erdoganeray/desk_buddy/kicad/Desk Buddy.kicad_pcb

## KiCad design eval/baro.kicad_sch

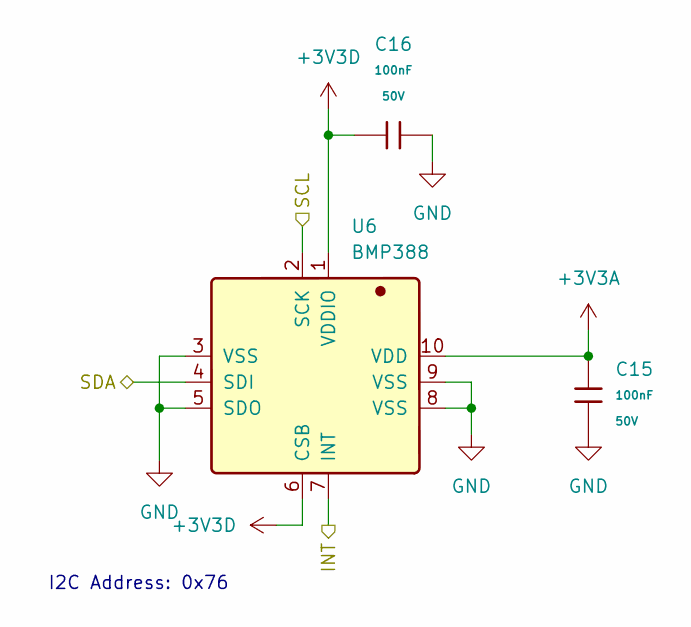
[picture p1: schematic baro.kicad_sch]

Parts:
C15, C16: 100nF; C_0805; Voltage Rated 50V; Tolerance ±10%; Part CC0805KRX7R9BB104; LCSC C49678
U6: BMP388; Manufacturer Part BMP388; LCSC C779278

Connections:
+3V3A: C15.1, U6.10 (VDD)
+3V3D: C16.1, U6.1 (VDDIO), U6.6 (CSB)
GND: C15.2, C16.2, U6.3 (VSS), U6.5 (SDO), U6.8 (VSS), U6.9 (VSS)
INT: U6.7 (INT)
SCL: U6.2 (SCK)
SDA: U6.4 (SDI)

Notes on the sheet:
I2C Address: 0x76
