erdoganeray/desk_buddy/kicad/Desk Buddy.kicad_pcb

## KiCad design eval/imu0.kicad_sch

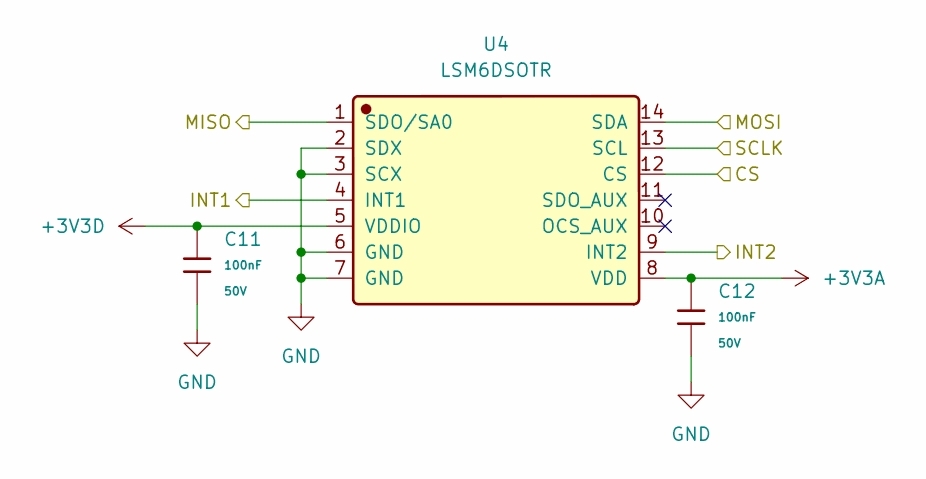
[picture p2: schematic imu0.kicad_sch]

Parts:
C11, C12: 100nF; C_0805; Voltage Rated 50V; Tolerance ±10%; Part CC0805KRX7R9BB104; LCSC C49678
U4: LSM6DSOTR; Bosch_LGA-14_3x2.5mm_P0.5mm; Manufacturer Part LSM6DSOTR; LCSC C2655100

Connections:
+3V3A: C12.1, U4.8 (VDD)
+3V3D: C11.1, U4.5 (VDDIO)
CS: U4.12 (CS)
GND: C11.2, C12.2, U4.2 (SDX), U4.3 (SCX), U4.6 (GND), U4.7 (GND)
INT1: U4.4 (INT1)
INT2: U4.9 (INT2)
MISO: U4.1 (SDO/SA0)
MOSI: U4.14 (SDA)
SCLK: U4.13 (SCL)
