erdoganeray/desk_buddy/kicad/Desk Buddy.kicad_pcb

## KiCad design eval/imu1.kicad_sch

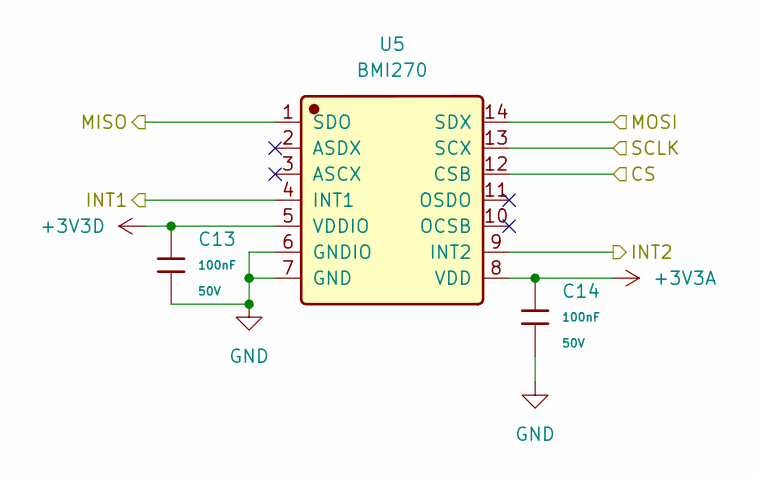
[picture p3: schematic imu1.kicad_sch]

Parts:
C13, C14: 100nF; C_0805; Voltage Rated 50V; Tolerance ±10%; Part CC0805KRX7R9BB104; LCSC C49678
U5: BMI270; Bosch_LGA-14_3x2.5mm_P0.5mm; Manufacturer Part BMI270; LCSC C2836813

Connections:
+3V3A: C14.1, U5.8 (VDD)
+3V3D: C13.1, U5.5 (VDDIO)
CS: U5.12 (CSB)
GND: C13.2, C14.2, U5.6 (GNDIO), U5.7 (GND)
INT1: U5.4 (INT1)
INT2: U5.9 (INT2)
MISO: U5.1 (SDO)
MOSI: U5.14 (SDX)
SCLK: U5.13 (SCX)
