erdoganeray/desk_buddy/kicad/Desk Buddy.kicad_pcb

## KiCad design eval/mag.kicad_sch

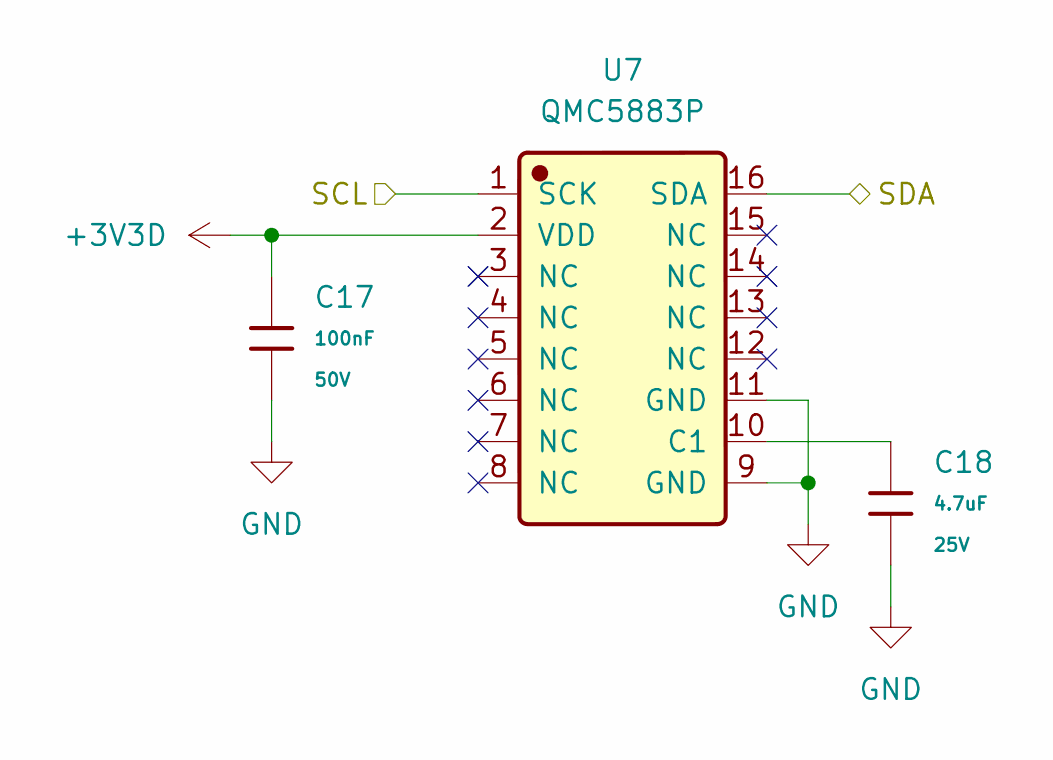
[picture p4: schematic mag.kicad_sch]

Parts:
C17: 100nF; C_0805; Voltage Rated 50V; Tolerance ±10%; Part CC0805KRX7R9BB104; LCSC C49678
C18: 4.7uF; C_0805; Voltage Rated 25V; Tolerance ±10%; Part CL21A475KAQNNNE; LCSC C1779
U7: QMC5883P; LGA-16_3x3mm_P0.5mm; Manufacturer Part QMC5883P; LCSC C2847467

Connections:
+3V3D: C17.1, U7.2 (VDD)
GND: C17.2, C18.2, U7.9 (GND), U7.11 (GND)
unnamed: C18.1, U7.10 (C1)
SCL: U7.1 (SCK)
SDA: U7.16 (SDA)
