erdoganeray/desk_buddy/kicad/Desk Buddy.kicad_pcb

## KiCad design eval/mcu.kicad_sch

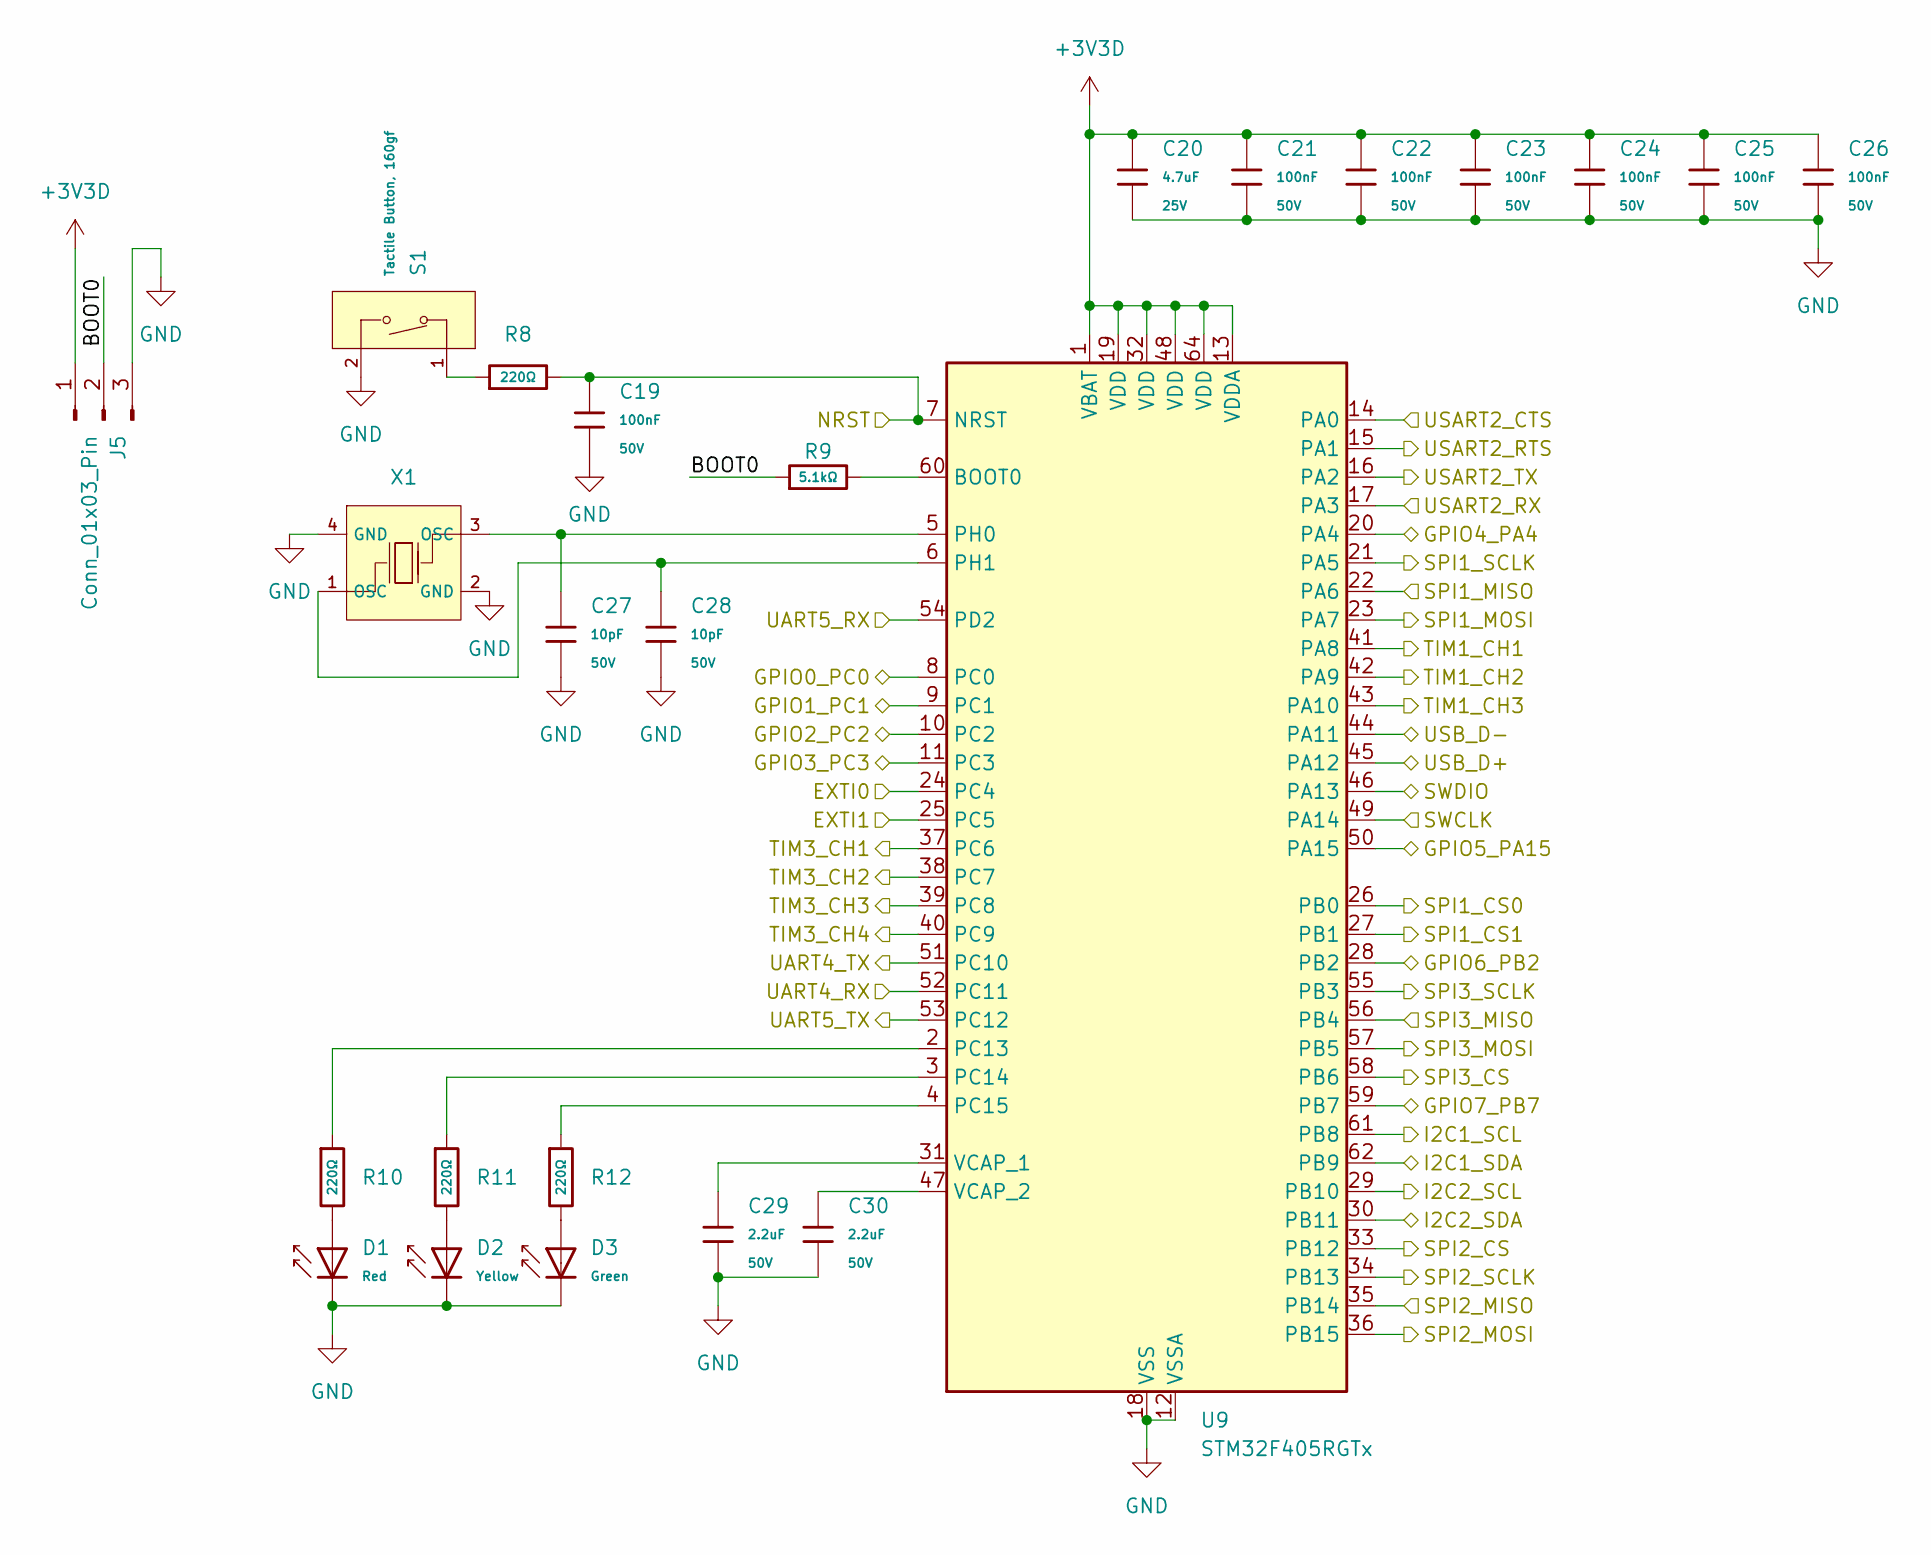
[picture p5: schematic mcu.kicad_sch]

Parts:
C19, C21, C22, C23, C24, C25, C26: 100nF; C_0805; Voltage Rated 50V; Tolerance ±10%; Part CC0805KRX7R9BB104; LCSC C49678
C20: 4.7uF; C_0805; Voltage Rated 25V; Tolerance ±10%; Part CL21A475KAQNNNE; LCSC C1779
C27, C28: 10pF; C_0603; Voltage Rated 50V; Tolerance ±5%; Part CL10C100JB8NNNC; LCSC C1634
C29, C30: 2.2uF; C_0805; Voltage Rated 50V; Tolerance ±10%; Part CL21A225KBQNNNE; LCSC C377773
D1: Red; D_0805; Forward Voltage (VF) 1.6V~2.6V; Part NCD0805R1; LCSC C84256
D2: Yellow; D_0805; Part KT-0805Y; LCSC C2296
D3: Green; D_0805; Part KT-0805G; LCSC C2297
J5: Conn_01x03_Pin; PinHeader_1x03_P2.54mm_Vertical
R8, R10, R11, R12: 220Ω; R_0805; Overload Voltage (Max) 150V; Tolerance ±1%; Part 0805W8F2200T5E; LCSC C17557
R9: 5.1kΩ; R_0805; Overload Voltage (Max) 150V; Tolerance ±1%; Part 0805W8F5101T5E; LCSC C27834
S1: Tactile Button, 160gf; SW_TS-1088-AR02016; Voltage Rating (Dc) 12V; Part TS-1088-AR02016; LCSC C720477
U9: STM32F405RGTx; LQFP-64_10x10mm_P0.5mm
X1: X322516MLB4SI; OSC-SMD_4P-L3.2-W2.5-BL; Frequency Tolerance ±10ppm; Part X322516MLB4SI; LCSC C13738

Connections:
+3V3D: C20.1, C21.1, C22.1, C23.1, C24.1, C25.1, C26.1, J5.1, U9.1 (VBAT), U9.13 (VDDA), U9.19 (VDD), U9.32 (VDD), U9.48 (VDD), U9.64 (VDD)
BOOT0: J5.2, R9.1
EXTI0: U9.24 (PC4)
EXTI1: U9.25 (PC5)
GND: C19.2, C20.2, C21.2, C22.2, C23.2, C24.2, C25.2, C26.2, C27.2, C28.2, C29.2, C30.2, D1.1, D2.1, D3.1, J5.3, S1.2 (B), U9.12 (VSSA), U9.18 (VSS), U9.63 (VSS), X1.2 (GND), X1.4 (GND)
GPIO0_PC0: U9.8 (PC0)
GPIO1_PC1: U9.9 (PC1)
GPIO2_PC2: U9.10 (PC2)
GPIO3_PC3: U9.11 (PC3)
GPIO4_PA4: U9.20 (PA4)
GPIO5_PA15: U9.50 (PA15)
GPIO6_PB2: U9.28 (PB2)
GPIO7_PB7: U9.59 (PB7)
I2C1_SCL: U9.61 (PB8)
I2C1_SDA: U9.62 (PB9)
I2C2_SCL: U9.29 (PB10)
I2C2_SDA: U9.30 (PB11)
NRST: C19.1, R8.2, U9.7 (NRST)
unnamed: C27.1, U9.5 (PH0), X1.3 (OSC)
unnamed: C28.1, U9.6 (PH1), X1.1 (OSC)
unnamed: C29.1, U9.31 (VCAP_1)
unnamed: C30.1, U9.47 (VCAP_2)
unnamed: D1.2, R10.2
unnamed: D2.2, R11.2
unnamed: D3.2, R12.2
unnamed: R8.1, S1.1 (A)
unnamed: R9.2, U9.60 (BOOT0)
unnamed: R10.1, U9.2 (PC13)
unnamed: R11.1, U9.3 (PC14)
unnamed: R12.1, U9.4 (PC15)
SPI1_CS0: U9.26 (PB0)
SPI1_CS1: U9.27 (PB1)
SPI1_MISO: U9.22 (PA6)
SPI1_MOSI: U9.23 (PA7)
SPI1_SCLK: U9.21 (PA5)
SPI2_CS: U9.33 (PB12)
SPI2_MISO: U9.35 (PB14)
SPI2_MOSI: U9.36 (PB15)
SPI2_SCLK: U9.34 (PB13)
SPI3_CS: U9.58 (PB6)
SPI3_MISO: U9.56 (PB4)
SPI3_MOSI: U9.57 (PB5)
SPI3_SCLK: U9.55 (PB3)
SWCLK: U9.49 (PA14)
SWDIO: U9.46 (PA13)
TIM1_CH1: U9.41 (PA8)
TIM1_CH2: U9.42 (PA9)
TIM1_CH3: U9.43 (PA10)
TIM3_CH1: U9.37 (PC6)
TIM3_CH2: U9.38 (PC7)
TIM3_CH3: U9.39 (PC8)
TIM3_CH4: U9.40 (PC9)
UART4_RX: U9.52 (PC11)
UART4_TX: U9.51 (PC10)
UART5_RX: U9.54 (PD2)
UART5_TX: U9.53 (PC12)
USART2_CTS: U9.14 (PA0)
USART2_RTS: U9.15 (PA1)
USART2_RX: U9.17 (PA3)
USART2_TX: U9.16 (PA2)
USB_D+: U9.45 (PA12)
USB_D-: U9.44 (PA11)
