erdoganeray/desk_buddy/kicad/Desk Buddy.kicad_pcb

## KiCad design eval/power.kicad_sch

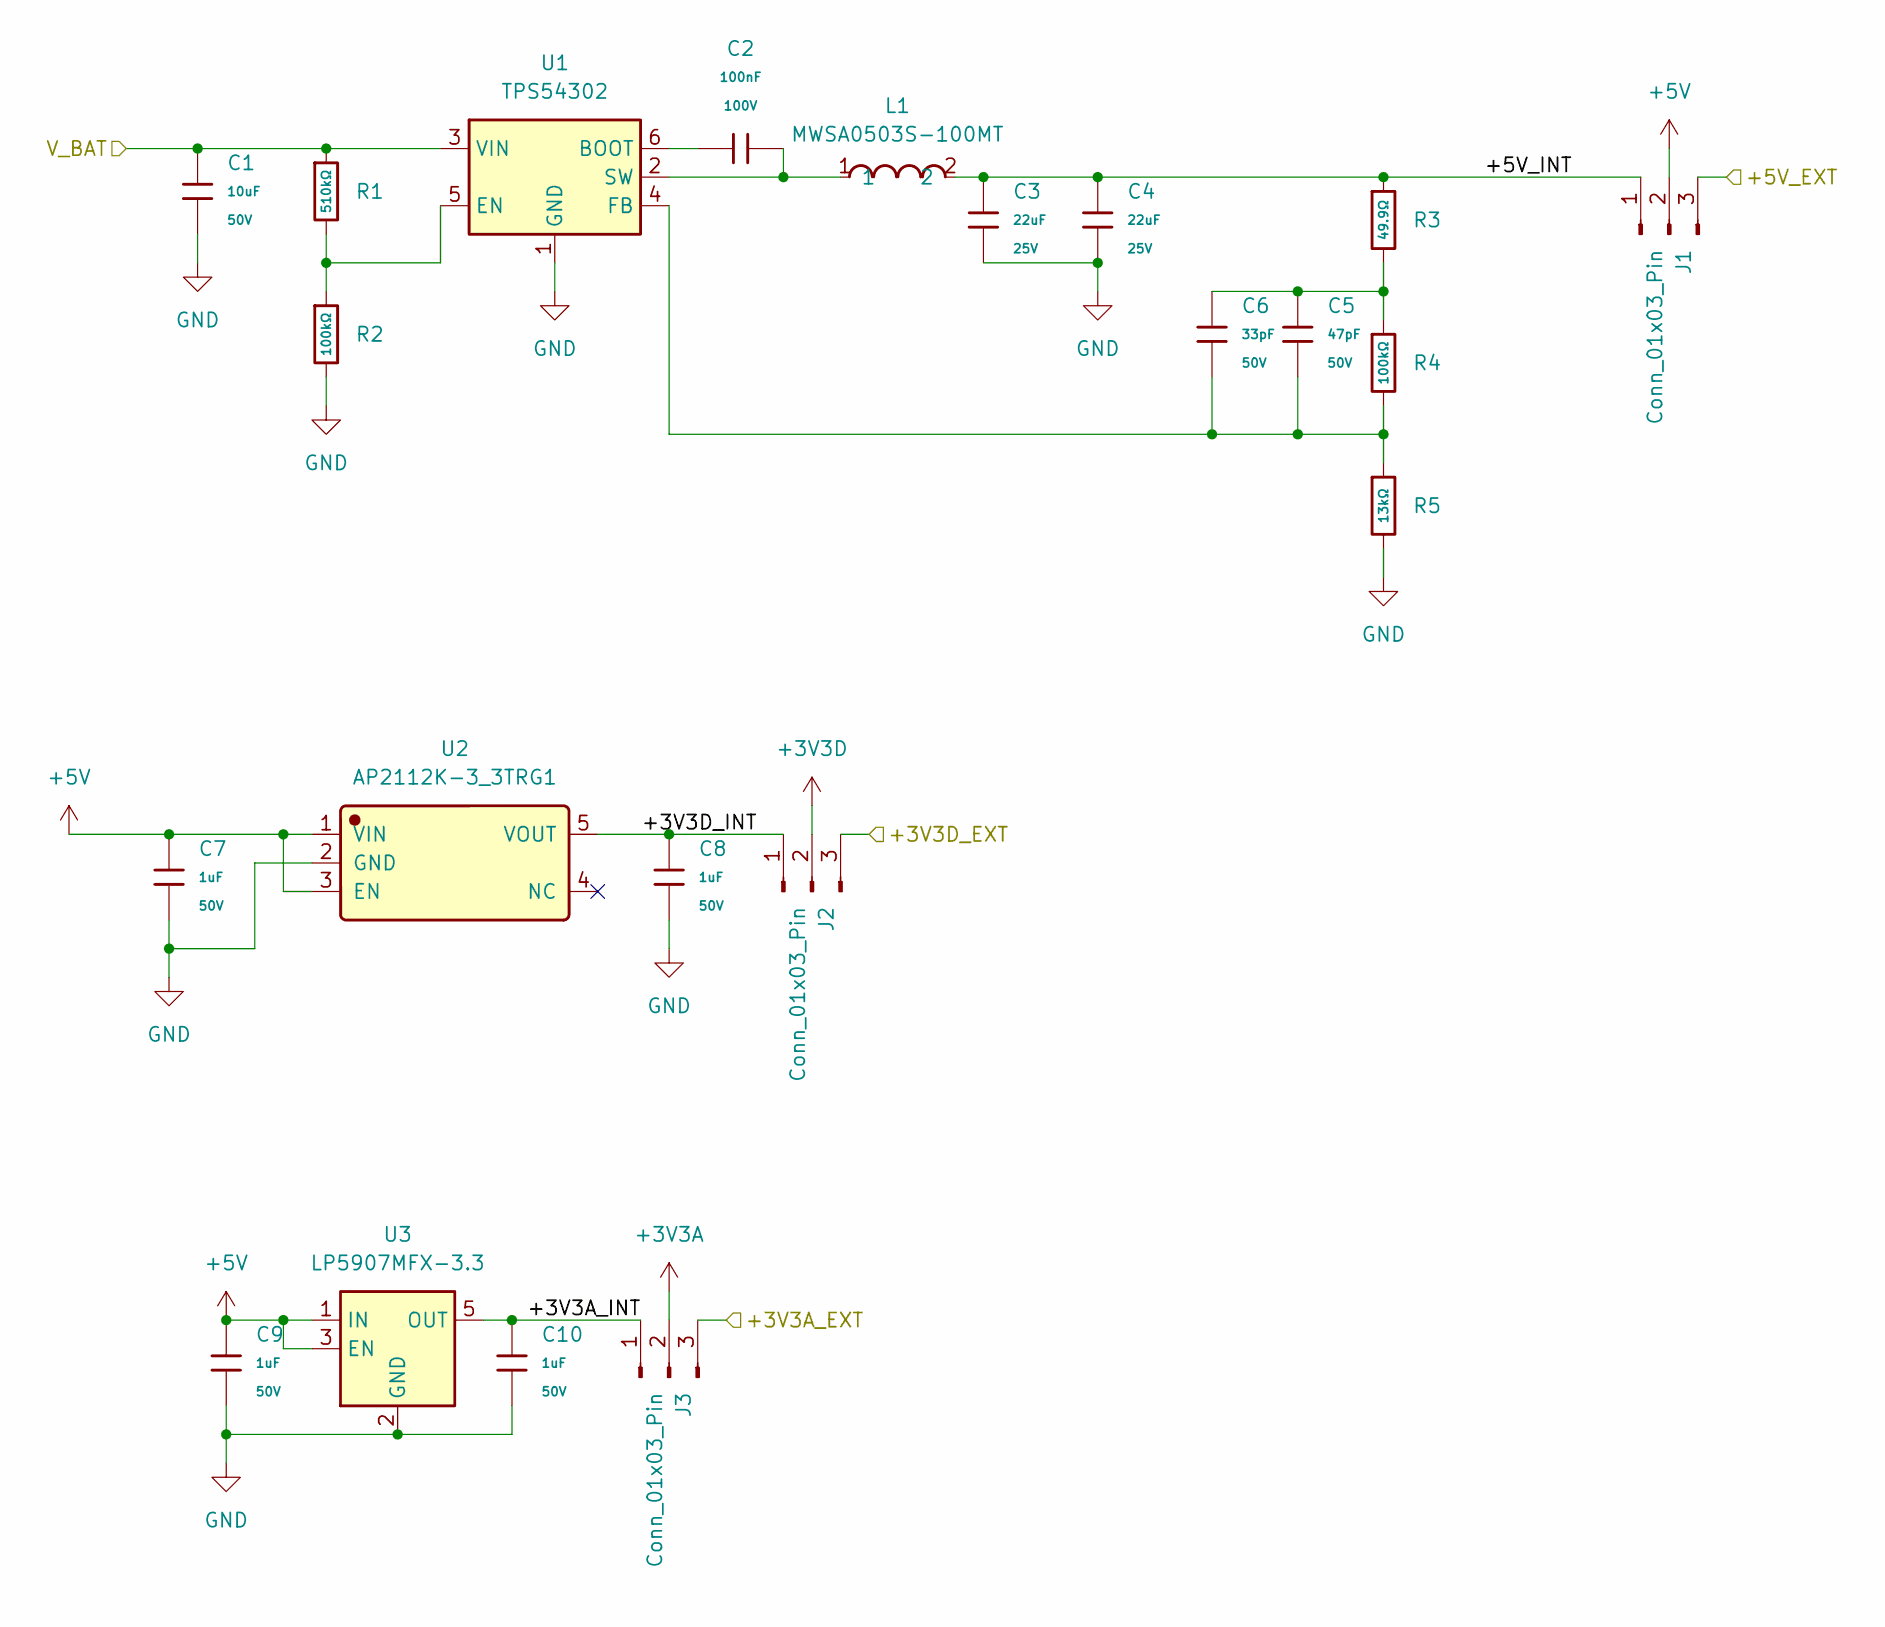
[picture p6: schematic power.kicad_sch]

Parts:
C1: 10uF; C_0805; Voltage Rated 50V; Tolerance ±10%; Part GRM21BR61H106KE43L; LCSC C440198
C2: 100nF; C_0805; Voltage Rated 100V; Tolerance ±10%; Part CL21B104KCFNNNE; LCSC C28233
C3, C4: 22uF; C_0805; Voltage Rated 25V; Tolerance ±20%; Part CL21A226MAQNNNE; LCSC C45783
C5: 47pF; C_0805; Voltage Rated 50V; Tolerance ±5%; Part CL21C470JBANNNC; LCSC C14857
C6: 33pF; C_0805; Voltage Rated 50V; Tolerance ±5%; Part CC0805JRNPO9BN330; LCSC C107115
C7, C8, C9, C10: 1uF; C_0805; Voltage Rated 50V; Tolerance ±10%; Part CL21B105KBFNNNE; LCSC C28323
J1, J2, J3: Conn_01x03_Pin; PinHeader_1x03_P2.54mm_Vertical
L1: MWSA0503S-100MT; SOIC-8_L5.3-W5.3-P1.27-LS8.0-BL; Manufacturer Part MWSA0503S-100MT; LCSC C408412
R1: 510kΩ; R_0805; Overload Voltage (Max) 150V; Tolerance ±1%; Part 0805W8F5103T5E; LCSC C17733
R2, R4: 100kΩ; R_0805; Overload Voltage (Max) 150V; Tolerance ±1%; Part 0805W8F1003T5E; LCSC C149504
R3: 49.9Ω; R_0805; Overload Voltage (Max) 150V; Tolerance ±1%; Part 0805W8F499JT5E; LCSC C17720
R5: 13kΩ; R_0805; Overload Voltage (Max) 150V; Tolerance ±1%; Part 0805W8F1302T5E; LCSC C17455
U1: TPS54302; SOT-23-6
U2: AP2112K-3_3TRG1; SC-74-6_1.55x2.9mm_P0.95mm; Manufacturer Part AP2112K-3.3TRG1; LCSC C51118
U3: LP5907MFX-3.3; SOT-23-5

Connections:
+3V3A: J3.2
+3V3A_EXT: J3.3
+3V3A_INT: C10.1, J3.1, U3.5 (OUT)
+3V3D: J2.2
+3V3D_EXT: J2.3
+3V3D_INT: C8.1, J2.1, U2.5 (VOUT)
+5V: C7.1, C9.1, J1.2, U2.1 (VIN), U2.3 (EN), U3.1 (IN), U3.3 (EN)
+5V_EXT: J1.3
+5V_INT: C3.1, C4.1, J1.1, L1.2, R3.1
GND: C1.2, C3.2, C4.2, C7.2, C8.2, C9.2, C10.2, R2.2, R5.2, U1.1 (GND), U2.2 (GND), U3.2 (GND)
unnamed: C2.1, U1.6 (BOOT)
unnamed: C2.2, L1.1, U1.2 (SW)
unnamed: C5.1, C6.1, R3.2, R4.1
unnamed: C5.2, C6.2, R4.2, R5.1, U1.4 (FB)
unnamed: R1.2, R2.1, U1.5 (EN)
V_BAT: C1.1, R1.1, U1.3 (VIN)
