erdoganeray/desk_buddy/kicad/Desk Buddy.kicad_pcb

## KiCad design eval/usb.kicad_sch

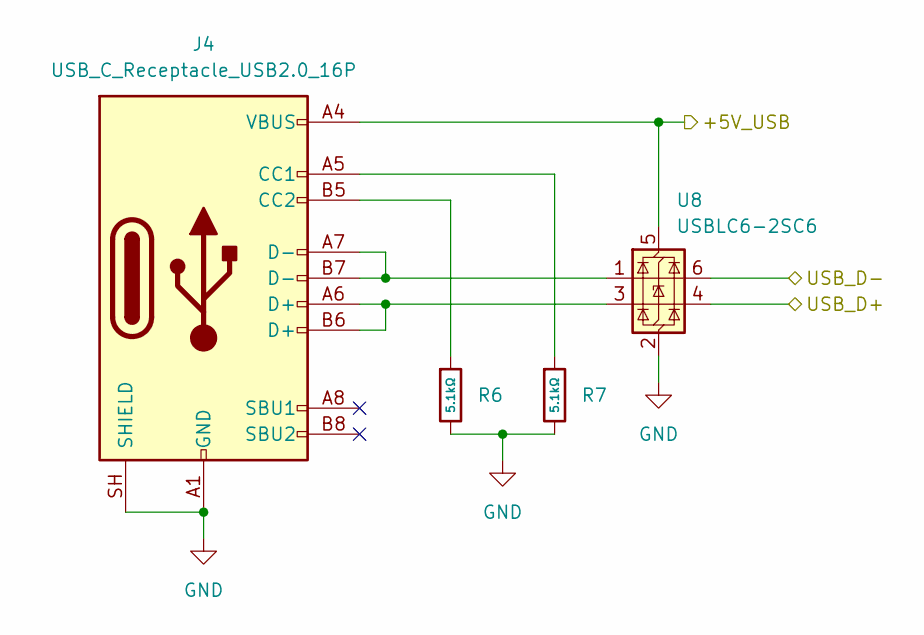
[picture p7: schematic usb.kicad_sch]

Parts:
J4: USB_C_Receptacle_USB2.0_16P; USB_C_Receptacle_GCT_USB4105-xx-A_16P_TopMnt_Horizontal
R6, R7: 5.1kΩ; R_0805; Overload Voltage (Max) 150V; Tolerance ±1%; Part 0805W8F5101T5E; LCSC C27834
U8: USBLC6-2SC6; SOT-23-6

Connections:
+5V_USB: J4.A4 (VBUS), J4.A9 (VBUS), J4.B4 (VBUS), J4.B9 (VBUS), U8.5 (VBUS)
GND: J4.A1 (GND), J4.A12 (GND), J4.B1 (GND), J4.B12 (GND), J4.SH (SHIELD), R6.2, R7.2, U8.2 (GND)
unnamed: J4.A5 (CC1), R7.1
unnamed: J4.A6 (D+), J4.B6 (D+), U8.3 (I/O2)
unnamed: J4.A7 (D-), J4.B7 (D-), U8.1 (I/O1)
unnamed: J4.B5 (CC2), R6.1
USB_D+: U8.4 (I/O2)
USB_D-: U8.6 (I/O1)
