erdoganeray/desk_buddy/(commit log)

2026-09-14 Initial project scaffold: BOM, schematic notes, and plan
    Sets up file structure to reconstruct a lost PCB design (ESP32-S3
    desk buddy device) from purchased components: BOM with confirmed
    MPNs, charger (BQ24075) design fully derived from its datasheet,
    peripheral pinouts for display/sensors/audio confirmed, and a
    development plan. KiCad project folder reserved but left empty.
2026-09-15 Finalize GPIO map, dual I2C bus, and 3.3V power budget
    - Full ESP32-S3-WROOM-1-N8R2 GPIO assignment from the official pin
    table: touch (XPT2046) added, two independent I2C buses (internal
    sensors vs. isolated external expansion), battery-voltage sense on
    GPIO3 (confirmed safe via strapping eFuse default), native-USB
    programming/debugging verified.
    - Power budget worked against AP2112K-3.3 datasheet and Espressif's
    WiFi TX current figures: original plan overshot the 600mA rail by
    ~67%. Fixed by moving WS2812B and LCD backlight to the battery
    rail (via AO3400A switches, correcting an earlier direct-GPIO
    backlight design that would have exceeded GPIO current limits).
    - Documente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
2026-09-19 Move KiCad project into kicad/ folder
    KiCad's "New Project" nested the files under a Desk Buddy/Desk Buddy/
    subfolder at the repo root (project-name folder), separate from the
    kicad/ folder already reserved for it. Relocated the .kicad_pro/
    .kicad_sch/.kicad_pcb files into kicad/ to match the intended layout.
    [Desk Buddy.kicad_pcb, Desk Buddy.kicad_sch]
2026-09-19 Recover real KiCad project settings, ignore local UI state
    Closing KiCad re-saved its project settings to the old (pre-move)
    path since it still had that location cached from before the files
    were relocated. Moved the now-populated kicad_pro over the stale
    empty placeholder and removed the leftover folder. Also added
    *.kicad_prl to .gitignore -- it's local view/UI state, not design
    data, and would otherwise churn on every KiCad session.
2026-09-19 Set up project-local KiCad symbol library
    Empty DeskBuddy.kicad_sym registered in the project's own
    sym-lib-table (not the machine-global one), so the repo stays
    self-contained on a fresh clone. Ready for the off-board module
    symbols (ToF, AHT20+BMP280, MPU6050, MAX98357A, TTP223).
2026-09-19 Add off-board module symbols: ToF, AHT20+BMP280, MPU6050, MAX98357A, TTP223
    Simple box symbols with each module's actual pin names/types, all
    marked Exclude from board (JST-cable-connected, not soldered onto
    this PCB) but kept in the BOM. Verified pin count, names, and
    electrical types against schematic-notes.md for each.
2026-09-19 LCD connects via JST like other sensors, not a direct 2.54mm header
    Decided to solder wires straight to the display module's own pads
    and bring it in through two JST connectors (4-pin power, 7-pin
    SPI+touch) instead of plugging the module's onboard header directly
    into the mainboard. Keeps the LCD's mounting position independent of
    where the mainboard sits, matching the other cable-connected
    sensors. Updates the earlier (now-superseded) 2.54mm-header plan.
2026-09-19 Add multi-unit LCD symbol (power + SPI/touch units)
    Represents the physical ILI9341+XPT2046 module as one symbol with
    two units (4-pin power group, 7-pin SPI+touch group) so it can be
    placed near its two separate JST connectors on the Display sheet
    while staying one BOM line / one Exclude-from-board part, matching
    the just-decided JST-cable connection plan instead of a direct
    2.54mm header.
2026-09-19 Create hierarchical sheet skeleton (9 sheets)
    Root sheet holds 9 empty subsheets matching schematic-notes.md's
    subsystem breakdown (Power, MCU, Display, two sensor buses, LED,
    Audio, Motor, misc I/O). No hierarchical sheet pins used -- cross-
    sheet nets will be wired with global labels per the KiCad plan.
    Also ignore .history/ (a local-history editor artifact that showed
    up as a nested git repo, unrelated to the project).
    [00_Power.kicad_sch, 01_MCU.kicad_sch, 02_Display.kicad_sch, 03_Sensors_I2C0.kicad_sch, 04_Sensors_I2C1_Expansion.kicad_sch, 05_LED.kicad_sch, 06_Audio.kicad_sch, 07_Motor.kicad_sch]
2026-09-19 Wire 00_Power: charger, LDO, USB-C, battery, status LEDs
    Full BQ24075RGT 16-pin wiring (TS/CE/EN1/EN2/PGOOD/VSS/CHG/OUT/ILIM/
    IN/TMR/SYSOFF/ISET per the locked pin table), AP2112K-3.3 LDO, USB-C
    receptacle with CC pull-downs and USBLC6-2SC6 ESD protection, LiPo
    battery + JST + voltage-sense divider, and CHG/PGOOD status LEDs.
    Added PWR_FLAG symbols on the VBUS and GND nets to satisfy ERC --
    both nets are only fed by passive-typed connector/battery pins, so
    ERC has nothing it recognizes as a driver without an explicit flag.
    Fixed USB-C SHIELD (tied to GND) and SBU1/SBU2 (no-connect, unused
    in a USB2.0-only design) along the way.
    Sheet ERC-clean except three cross-sheet nets (USB_D-, USB_D+,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
    [00_Power.kicad_sch, 01_MCU.kicad_sch, 02_Display.kicad_sch, 03_Sensors_I2C0.kicad_sch, 04_Sensors_I2C1_Expansion.kicad_sch, 05_LED.kicad_sch, 06_Audio.kicad_sch, 07_Motor.kicad_sch]
2026-09-20 Wire 01_MCU: ESP32-S3, boot/reset/power buttons, all GPIO labels
    ESP32-S3-WROOM-1 with VDD3P3 bulk cap, three button circuits
    (EN/reset with debounce cap, IO0/boot, IO2/power - all 10k pull-up
    to 3V3), USB_D-/USB_D+ tied to 00_Power's global labels, and a
    global label on every remaining assigned GPIO matching the locked
    pin table (LCD_*, I2C0_*, I2C1_*, I2S_*, TOF_*, TTP223_*, UART_*,
    WS2812_*, MOTOR_PWM, LDR_ADC, CHG_CE, VBAT_SENSE). IO45/IO46 left
    untouched (strapping). Added a 3-pin header (3V3/GND/GPIO48_SPARE)
    for the one free GPIO, and two TestPoint pads (3V3, VBAT_OUT) on
    00_Power for quick multimeter access.
    ERC: 0 errors, 27 warnings -- all "label connected to only one pin"
    on the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
    [00_Power.kicad_sch, 01_MCU.kicad_sch, 02_Display.kicad_sch, 03_Sensors_I2C0.kicad_sch, 04_Sensors_I2C1_Expansion.kicad_sch, 05_LED.kicad_sch, 06_Audio.kicad_sch, 07_Motor.kicad_sch]
2026-09-20 Wire 02_Display: LCD (2-unit), JST-A/JST-B, backlight switch
    LCD's power unit (VCC/GND/LED/RESET) wired to JST-A (4-pin), SPI+
    touch unit (CS/DC/MOSI/SCK/MISO/T_CS/T_IRQ) wired to JST-B (7-pin),
    each JST pin sharing its net with the corresponding LCD symbol pin
    per the cable-connected-module pattern used throughout. VCC stays
    on 3V3; LED (backlight) switches via a second AO3400A off VBAT_OUT,
    gate driven by LCD_BL_GATE through a 100R series resistor with a
    10k gate pull-down so the backlight defaults off during boot.
    ERC: 0 errors, 18 warnings, all isolated labels for sheets not yet
    wired -- exactly the expected set (9 fewer than before, matching
    this sheet's 9 LCD_* labels resolving agains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
    [02_Display.kicad_sch]
2026-09-20 Wire 03_Sensors_I2C0: ToF, AHT20+BMP280, MPU6050
    Three internal-bus sensors each wired symbol-to-JST on shared nets
    (6-pin for ToF incl. INT/SHUT, 4-pin each for AHT20+BMP280 and
    MPU6050), all on I2C0_SDA/I2C0_SCL with one pair of 4.7k pull-ups
    to 3V3 for the whole bus.
    ERC: 0 errors, 14 warnings, all isolated labels for sheets not yet
    wired -- 4 fewer than before (I2C0_SDA, I2C0_SCL, TOF_INT, TOF_SHUT
    now resolved against 01_MCU).
    [02_Display.kicad_sch, 03_Sensors_I2C0.kicad_sch]
2026-09-20 Wire 04_Sensors_I2C1_Expansion: two parallel external JST ports
    Both 4-pin JSTs wired identically (VCC/GND/SDA/SCL) onto the same
    isolated I2C1 bus, with one pair of 4.7k pull-ups to 3V3. No
    sensors on this sheet by design -- it's the open expansion port for
    future I2C devices or the planned mini-gamepads.
    ERC: 0 errors, 12 warnings, all isolated labels for sheets not yet
    wired -- 2 fewer than before (I2C1_SDA, I2C1_SCL now resolved).
    [04_Sensors_I2C1_Expansion.kicad_sch]
2026-09-20 Wire 05_LED: onboard WS2812B chain + external JST output
    Two onboard WS2812B daisy-chained (DIN from WS2812_ONBOARD, DOUT1->
    DIN2, DOUT2 no-connect at end of chain), both powered from VBAT_OUT.
    External 3-pin JST carries VBAT_OUT/GND/data, with a 330R series
    resistor between WS2812_EXT and the JST's data pin for signal
    integrity on the longer external run.
    ERC: 0 errors, 10 warnings, all isolated labels for sheets not yet
    wired -- 2 fewer than before (WS2812_ONBOARD, WS2812_EXT resolved).
    [05_LED.kicad_sch]
2026-09-20 Wire 06_Audio: MAX98357A + 6-pin JST
    VCC to VBAT_OUT, GND, and BCLK/LRC/DIN/SD to their matching I2S_*
    global labels. GAIN left unrouted (NC on the module itself, 15dB
    default).
    ERC: 0 errors, 6 warnings, all isolated labels for sheets not yet
    wired -- 4 fewer than before (all four I2S_* labels resolved).
    [06_Audio.kicad_sch]
2026-09-20 Wire 07_Motor: vibration motor switch with flyback protection
    AO3400A low-side switch (gate via 100R from MOTOR_PWM, 10k pull-down
    to default off at boot), BAT54 Schottky across the motor terminals
    (cathode to VBAT_OUT, anode to the switched node) to clamp turn-off
    inductive kickback, 2-pin JST to the motor.
    ERC: 0 errors, 5 warnings -- MOTOR_PWM now resolved, leaving exactly
    the 5 labels that belong to the last sheet, 08_Misc_IO.
    [07_Motor.kicad_sch]
2026-09-20 Wire 08_Misc_IO: complete the schematic -- full project ERC clean
    LDR (off-board, 2-pin JST + onboard 10k divider tapped by LDR_ADC),
    two TTP223 touch sensors (3-pin JST each, OUT to TTP223_1/2), and a
    4-pin UART breakout (3V3/GND/TX/RX). This was the last unwired
    sheet.
    Full project ERC: 0 errors, 0 warnings across all 9 sheets. Every
    peripheral from BOM.md is captured and connected per the locked
    GPIO map in schematic-notes.md. Schematic capture is done; next up
    is PCB layout.
    Also updates plan.md's KiCad section to reflect the finished
    schematic phase.
    [08_Misc_IO.kicad_sch]
2026-10-09 Footprint atamaları düzeltildi, satın alım listesi eklendi
    - R/C/LED 0805, USB-C USB4110, tactile switch PTS645SM43SMTR92
    - C6 47uF 1206, D5 BAT54 yerine SS14 (SMA)
    - J8 JST ve TestPoint footprint'leri atandı
    - purchase-list.md eklendi, BOM/plan/notlar güncellendi
    [00_Power.kicad_sch, 01_MCU.kicad_sch, 02_Display.kicad_sch, 03_Sensors_I2C0.kicad_sch, 04_Sensors_I2C1_Expansion.kicad_sch, 05_LED.kicad_sch, 07_Motor.kicad_sch, 08_Misc_IO.kicad_sch]
